phuclevinh2000/DHT22-sensor-using-Modbus-RS485-protocol/FINAL CIRCUIT.jpg

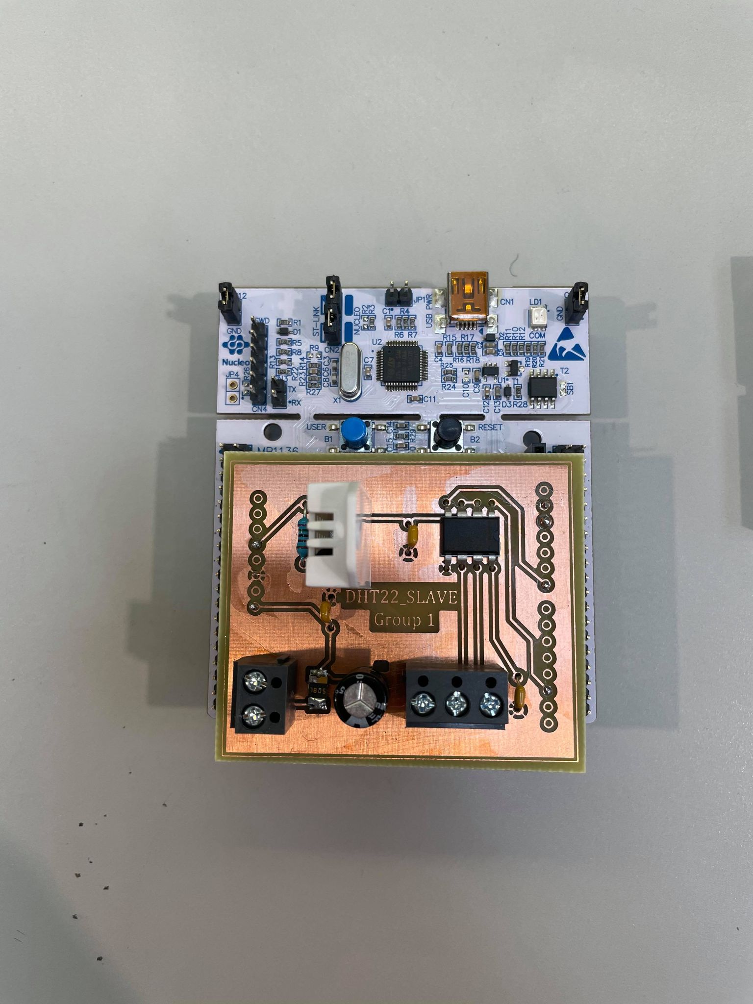
FINAL CIRCUIT.jpg
