phuclevinh2000/DHT22-sensor-using-Modbus-RS485-protocol/DHT22_slave_PADS/PCB_schematic_capacitor.PNG

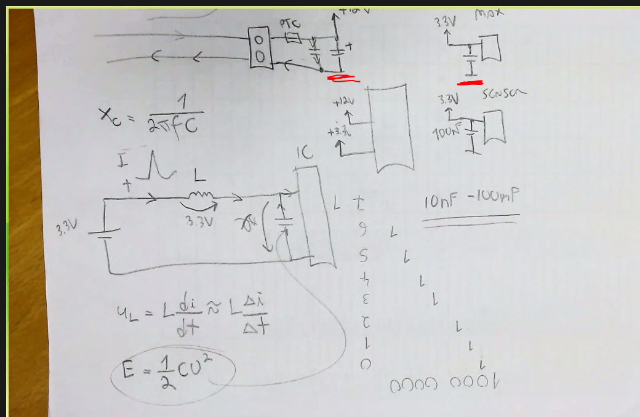
DHT22_slave_PADS/PCB_schematic_capacitor.PNG
