phuclevinh2000/DHT22-sensor-using-Modbus-RS485-protocol/(list of files, drawings)

Other design files:
DHT22_slave_PADS/slave_layout.pcb
DHT22_slave_PADS/slave_layout_new.pcb
